RiceTaco/5v-Led-Driver/block diagram/Block Diagram.png

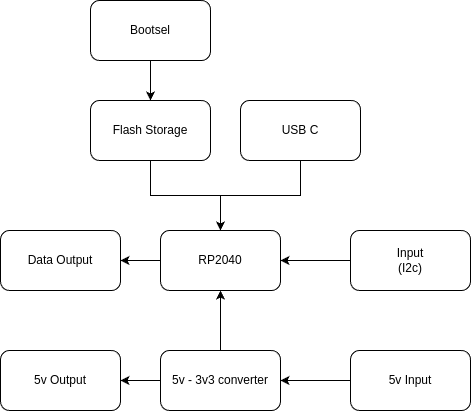
block diagram/Block Diagram.png
