RiceTaco/5v-Led-Driver/pcb/Parts/ABM8G_12/ABM8G_12_000MHZ_B4Y_T/CRYSTAL_ABM8G_ABR.step

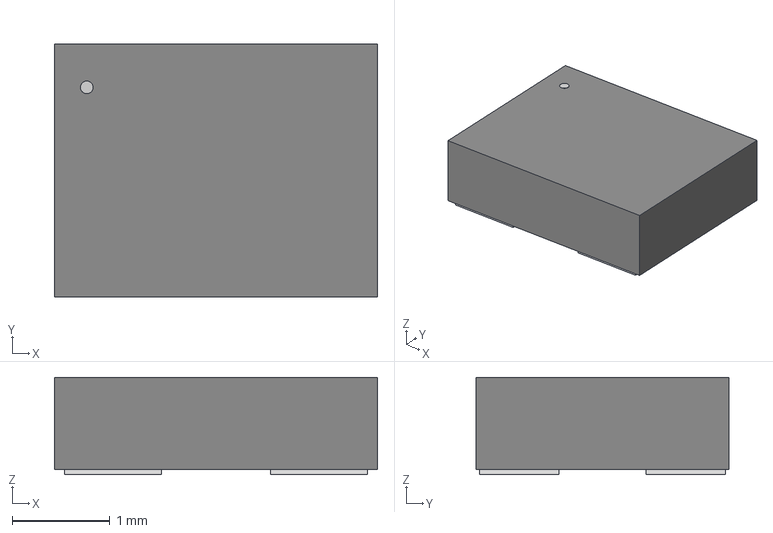
[picture p2: CAD file, 2025-01-21]
pcb/Parts/ABM8G_12/ABM8G_12_000MHZ_B4Y_T/CRYSTAL_ABM8G_ABR.step
3.30 x 2.59 x 0.993 mm
