RiceTaco/5v-Led-Driver/pcb/Parts/PTS815/CKCOMPONENTS_PTS815SJM250SMTRLFS/PTS815SJM250SMTRLFS.stp

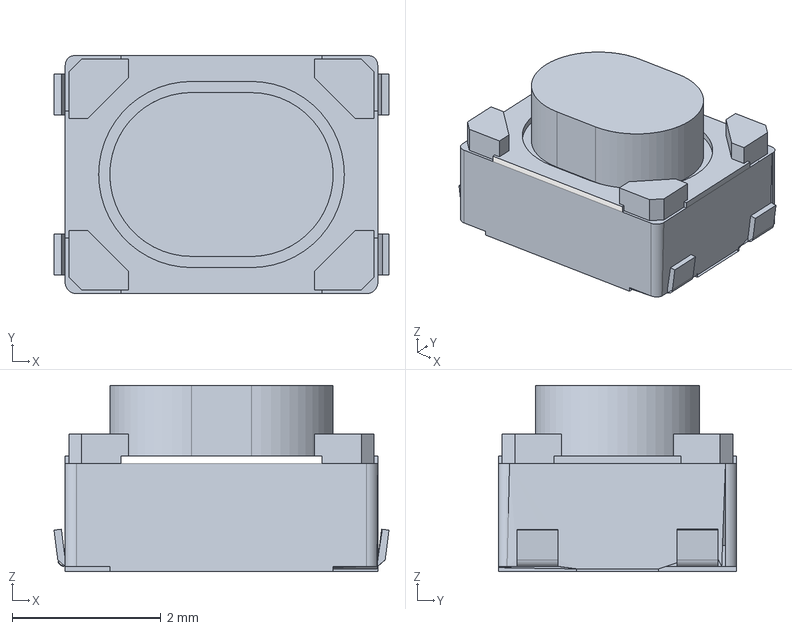
[picture p3: CAD file, 2025-01-21]
pcb/Parts/PTS815/CKCOMPONENTS_PTS815SJM250SMTRLFS/PTS815SJM250SMTRLFS.stp
4.50 x 3.20 x 2.50 mm
PTS815SJM250SMTRLFS_PART1
PTS815SJM250SMTRLFS_PART2
PTS815SJM250SMTRLFS_PART3
