RiceTaco/5v-Led-Driver/pcb/Parts/RP2040/RP2040/RP2040.step

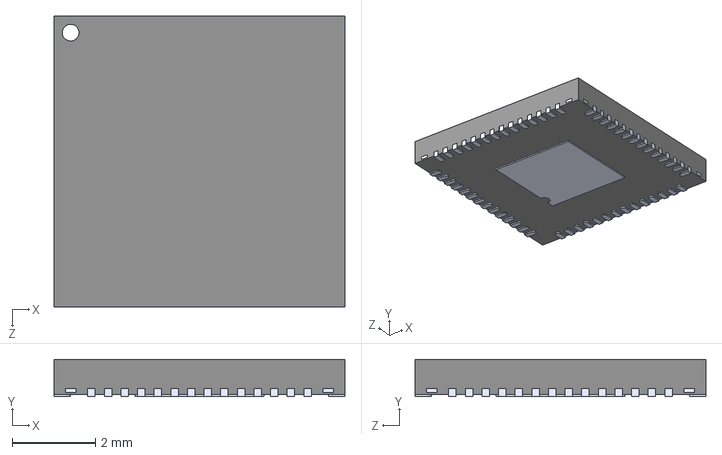
[picture p4: CAD file, 2025-01-21]
pcb/Parts/RP2040/RP2040/RP2040.step
7.00 x 0.9 x 7.00 mm
