RiceTaco/5v-Led-Driver/pcb/Parts/RT6150B/RT6150B_33GQW/RT6150B-33GQW.step

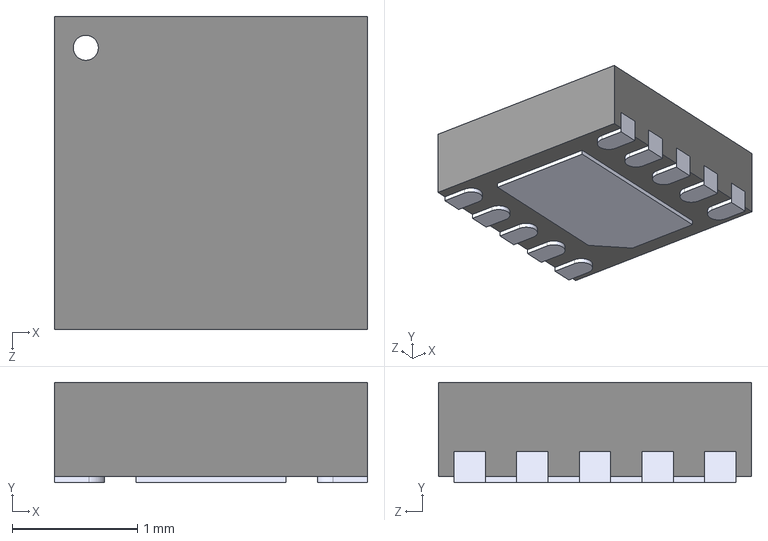
[picture p5: CAD file, 2025-01-21]
pcb/Parts/RT6150B/RT6150B_33GQW/RT6150B-33GQW.step
2.50 x 0.8 x 2.50 mm
