RiceTaco/5v-Led-Driver/pcb/Parts/RT6150B/RT6150B_33GQW_footprint/10-WFDFN-EP_RIT.step

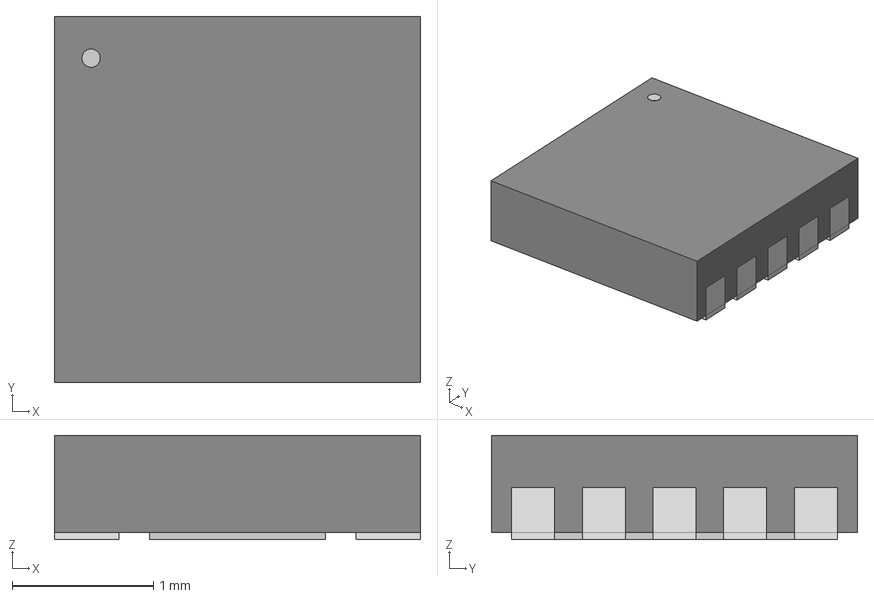
[picture p6: CAD file, 2025-01-21]
pcb/Parts/RT6150B/RT6150B_33GQW_footprint/10-WFDFN-EP_RIT.step
2.59 x 2.59 x 0.739 mm
