RiceTaco/5v-Led-Driver/pcb/Parts/W25Q16/W25Q16JVUXIQ_TR/USON-8_UX_2x3x0p6_WIN.step

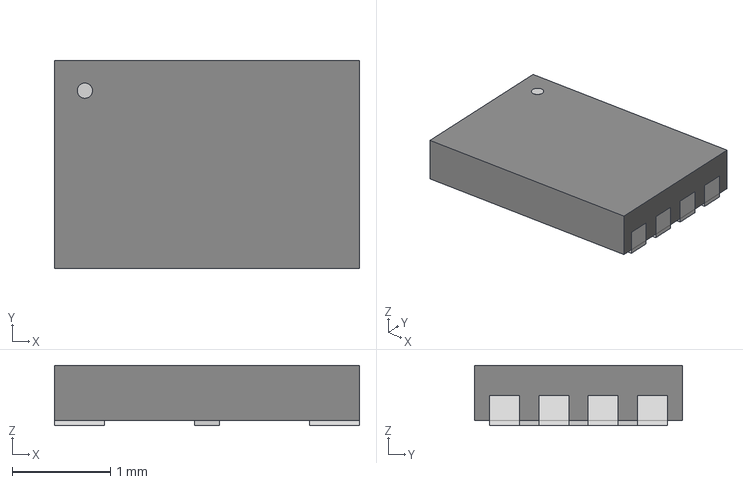
[picture p7: CAD file, 2025-01-21]
pcb/Parts/W25Q16/W25Q16JVUXIQ_TR/USON-8_UX_2x3x0p6_WIN.step
3.10 x 2.11 x 0.612 mm
