RiceTaco/5v-Led-Driver/pcb/Parts/ABM8G_12/ABM8G_12_000MHZ_B4Y_T/ABM8G-12.000MHZ-B4Y-T.step

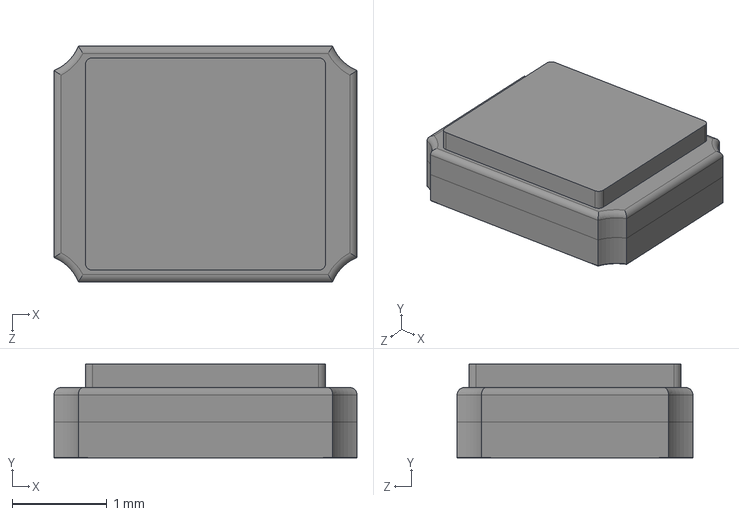
[picture p8: CAD file, 2025-01-21]
pcb/Parts/ABM8G_12/ABM8G_12_000MHZ_B4Y_T/ABM8G-12.000MHZ-B4Y-T.step
3.20 x 0.991 x 2.49 mm
