RiceTaco/5v-Led-Driver/pcb/5v Led Driver.kicad_pcb

## KiCad design pcb/5v Led Driver.kicad_pcb (2025-02-04)

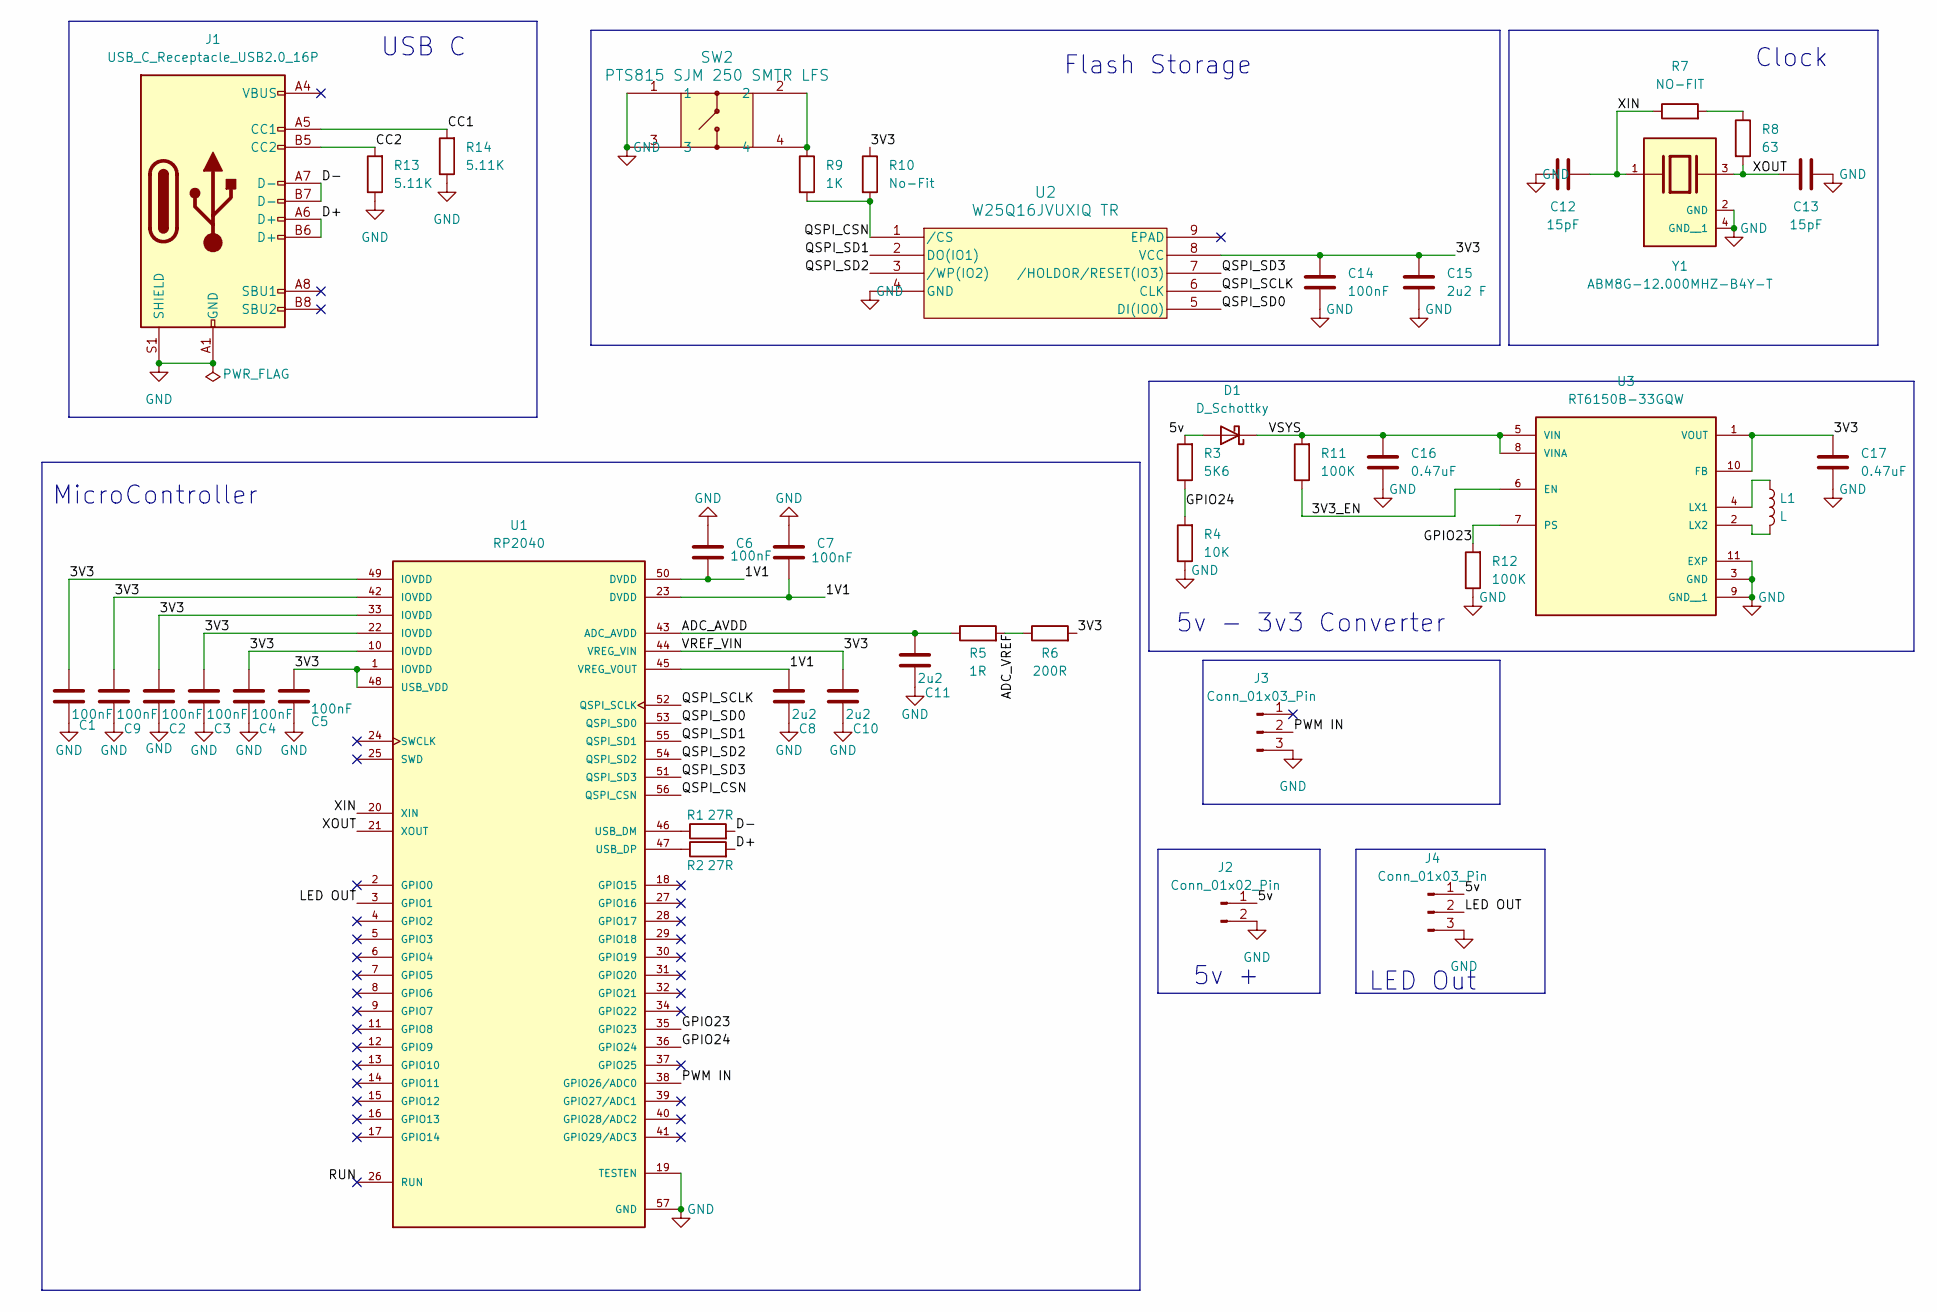
[picture p9: schematic 5v Led Driver.kicad_sch]

Parts:
C1, C2, C3, C4, C5, C6, C7, C9, C14: 100nF; C_0201_0603Metric
C8, C10, C11: 2u2; C_0201_0603Metric
C12, C13: 15pF; C_0201_0603Metric
C15: 2u2 F; C_0201_0603Metric
C16, C17: 0.47uF; C_0201_0603Metric
D1: D_Schottky; D_SOD-123F
J1: USB_C_Receptacle_USB2.0_16P; USB_C_Receptacle_G-Switch_GT-USB-7010ASV
J2: Conn_01x02_Pin; PinHeader_1x02_P2.54mm_Horizontal
J3, J4: Conn_01x03_Pin; PinHeader_1x03_P2.54mm_Horizontal
L1: L; L_0603_1608Metric
R1, R2: 27R; R_0201_0603Metric
R3: 5K6; R_0201_0603Metric
R4: 10K; R_0201_0603Metric
R5: 1R; R_0201_0603Metric
R6: 200R; R_0201_0603Metric
R7: NO-FIT; R_0201_0603Metric
R8: 63; R_0201_0603Metric
R9: 1K; R_0201_0603Metric
R10: No-Fit; R_0201_0603Metric
R11, R12: 100K; R_0201_0603Metric
R13, R14: 5.11K; R_0201_0603Metric
SW2: PTS815 SJM 250 SMTR LFS; SW4_PTS815 SJM 250 SMTR LFS_CNK
U1: RP2040; QFN-56-1EP_7x7mm_P0.4mm_EP3.2x3.2mm_ThermalVias; PARTREV 1.6.1
U2: W25Q16JVUXIQ TR; USON-8_UX_2x3x0p6_WIN
U3: RT6150B-33GQW; 10-WFDFN-EP_RIT; PARTREV July 2018
Y1: ABM8G-12.000MHZ-B4Y-T; CRYSTAL_ABM8G_ABR; PARTREV 08.13.15

Connections:
/1V1: C6.2, C7.2, C8.1, U1.23 (DVDD), U1.45 (VREG_VOUT), U1.50 (DVDD)
/3V3: C1.1, C2.1, C3.1, C4.1, C5.1, C9.1, C10.1, C14.1, C15.1, C17.1, R6.2, R10.1, U1.1 (IOVDD), U1.10 (IOVDD), U1.22 (IOVDD), U1.33 (IOVDD), U1.42 (IOVDD), U1.44 (VREG_VIN), U1.48 (USB_VDD), U1.49 (IOVDD), U2.8 (VCC), U3.1 (VOUT), U3.10 (FB)
/3V3_EN: R11.1, U3.6 (EN)
/5v: D1.2 (A), J2.1, J4.1, R3.2
/ADC_AVDD: C11.1, R5.1, U1.43 (ADC_AVDD)
/ADC_VREF: R5.2, R6.1
/CC1: J1.A5 (CC1), R14.2
/CC2: J1.B5 (CC2), R13.2
/D+: J1.A6 (D+), J1.B6 (D+), R2.2
/D-: J1.A7 (D-), J1.B7 (D-), R1.2
/GPIO23: R12.2, U1.35 (GPIO23), U3.7 (PS)
/GPIO24: R3.1, R4.2, U1.36 (GPIO24)
/LED OUT: J4.2, U1.3 (GPIO1)
/PWM IN: J3.2, U1.38 (GPIO26/ADC0)
/QSPI_CSN: R9.2, R10.2, U1.56 (QSPI_CSN), U2.1 (/CS)
/QSPI_SCLK: U1.52 (QSPI_SCLK), U2.6 (CLK)
/QSPI_SD0: U1.53 (QSPI_SD0), U2.5 (DI(IO0))
/QSPI_SD1: U1.55 (QSPI_SD1), U2.2 (DO(IO1))
/QSPI_SD2: U1.54 (QSPI_SD2), U2.3 (/WP(IO2))
/QSPI_SD3: U1.51 (QSPI_SD3), U2.7 (/HOLDOR/RESET(IO3))
/RUN: U1.26 (RUN)
/VSYS: C16.1, D1.1 (K), R11.2, U3.5 (VIN), U3.8 (VINA)
/XIN: C12.2, R7.1, U1.20 (XIN), Y1.1
/XOUT: C13.1, R8.2, U1.21 (XOUT), Y1.3
GND: C1.2, C2.2, C3.2, C4.2, C5.2, C6.1, C7.1, C8.2, C9.2, C10.2, C11.2, C12.1, C13.2, C14.2, C15.2, C16.2, C17.2, J1.A1 (GND), J1.A12 (GND), J1.B1 (GND), J1.B12 (GND), J1.S1 (SHIELD), J2.2, J3.3, J4.3, R4.1, R12.1, R13.1, R14.1, SW2.1, SW2.3, U1.19 (TESTEN), U1.57 (GND), U2.4 (GND), U3.3 (GND), U3.9 (GND__1), U3.11 (EXP), Y1.2 (GND), Y1.4 (GND__1)
unnamed: R7.2, R8.1
unnamed: R9.1, SW2.2, SW2.4
unnamed: R1.1, U1.46 (USB_DM)
unnamed: R2.1, U1.47 (USB_DP)
unnamed: L1.1, U3.4 (LX1)
unnamed: L1.2, U3.2 (LX2)

Notes on the sheet:
USB C
MicroController
Clock
5v - 3v3 Converter
LED Out
5v +
Flash Storage

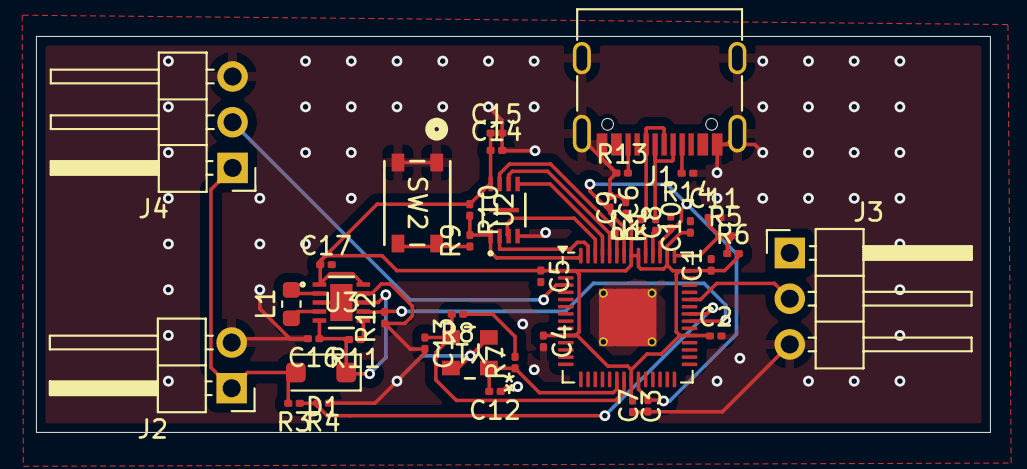
[picture p10: board 5v Led Driver.kicad_pcb from above]

Board: 2 copper layers, 53.0 x 22.0 mm, 42 parts (0 on the bottom side), 30 nets.
