RiceTaco/5v-Led-Driver/(commit log)

2025-01-21 Your commit message here
    [10-WFDFN-EP_RIT.step, 5v Led Driver.kicad_pcb, 5v Led Driver.kicad_sch, ABM8G-12.000MHZ-B4Y-T.step, CRYSTAL_ABM8G_ABR.step, PTS815SJM250SMTRLFS.stp, RP2040.step, RT6150B-33GQW.step]
2025-02-02 cant link pwmRead
2025-02-03 cant access pwmRead
    [10-WFDFN-EP_RIT.step, 5v Led Driver.kicad_pcb, 5v Led Driver.kicad_sch, ABM8G-12.000MHZ-B4Y-T.step, CRYSTAL_ABM8G_ABR.step, PTS815SJM250SMTRLFS.stp, RP2040.step, RT6150B-33GQW.step]
2025-02-04 usbc mabye not good
    [5v Led Driver.kicad_pcb]
2025-02-13 switched to micropython
    [10-WFDFN-EP_RIT.step, 5v Led Driver.kicad_pcb, 5v Led Driver.kicad_sch, ABM8G-12.000MHZ-B4Y-T.step, CRYSTAL_ABM8G_ABR.step, PTS815SJM250SMTRLFS.stp, RP2040.step, RT6150B-33GQW.step]
