RiceTaco/5v-Led-Driver/(notices)

Notices in the files:
pcb/Parts/PTS815/CKCOMPONENTS_PTS815SJM250SMTRLFS/PTS815SJM250SMTRLFS.stp:
author */ ('License CC BY-ND 4.0'),
